GGong02/CAN-do-it_Capstone/perfboard_layout_bottom.png

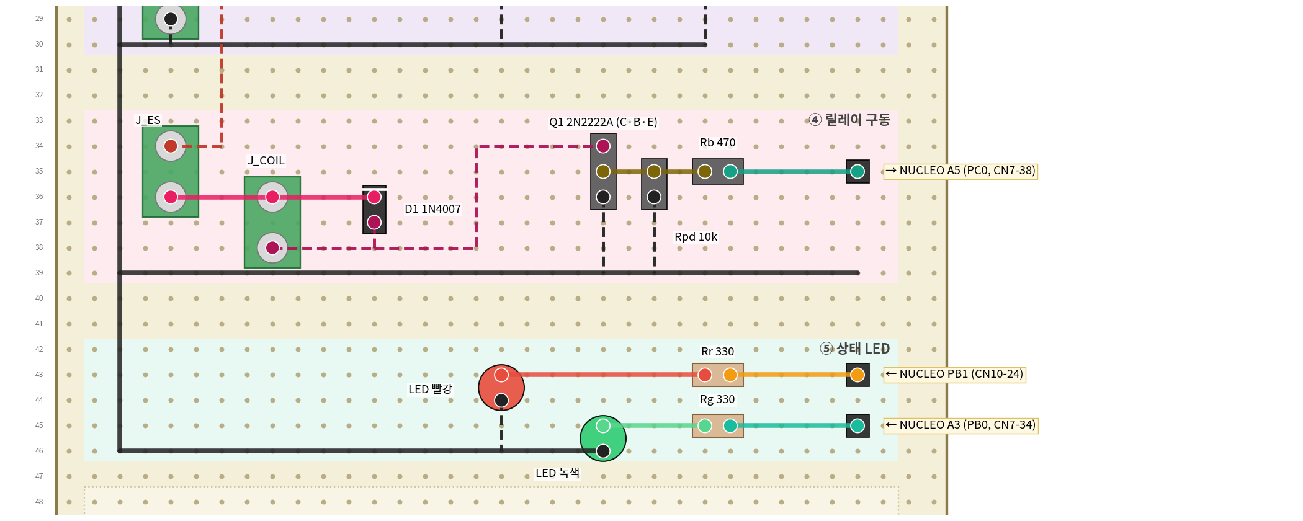
perfboard_layout_bottom.png
