GGong02/CAN-do-it_Capstone/perfboard_layout_full.png

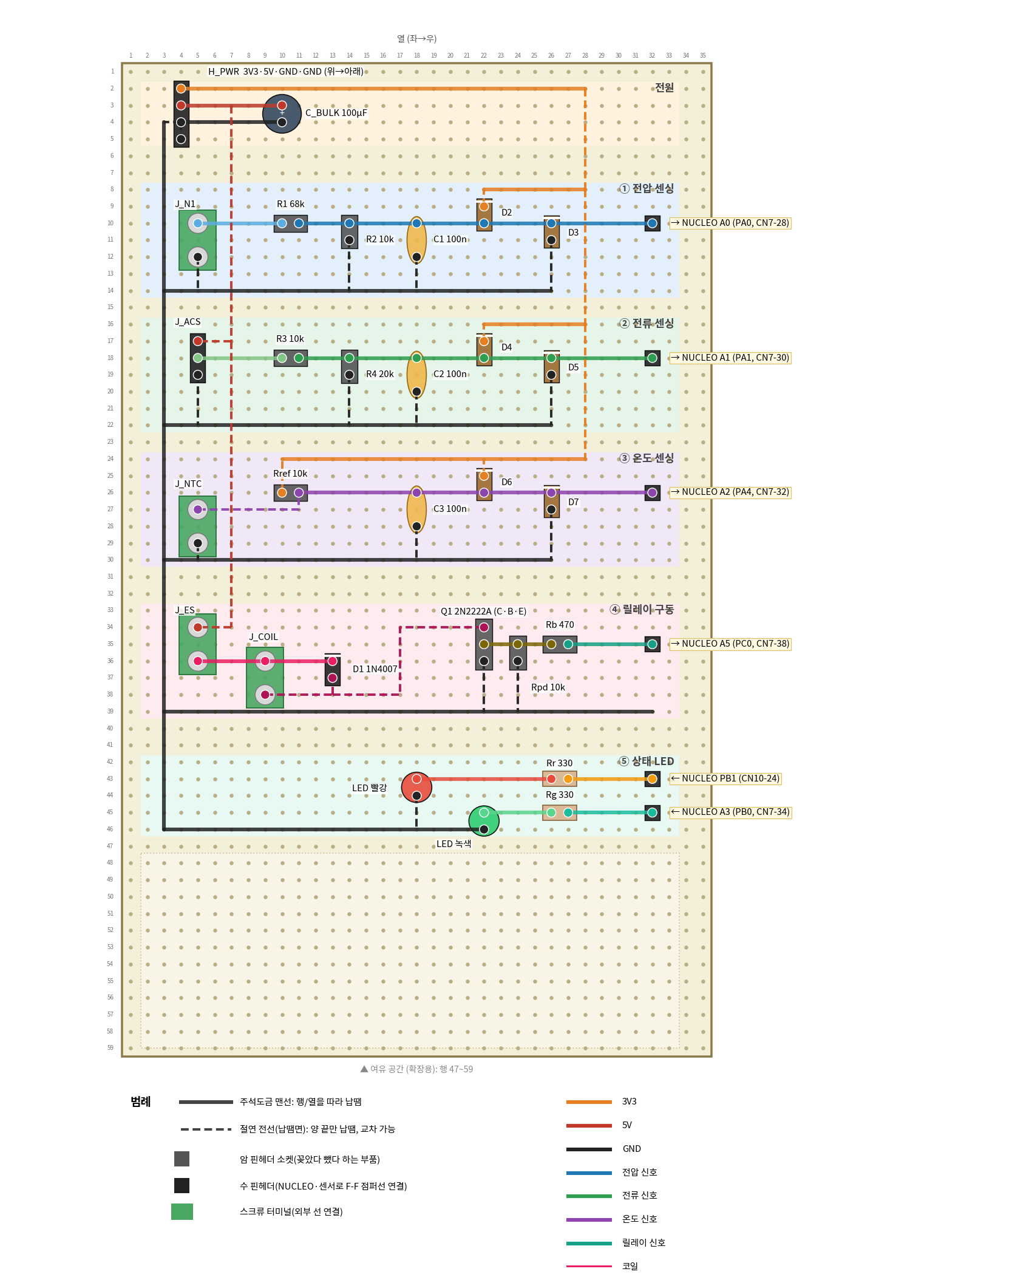
perfboard_layout_full.png
