GGong02/CAN-do-it_Capstone/perfboard_layout_top.png

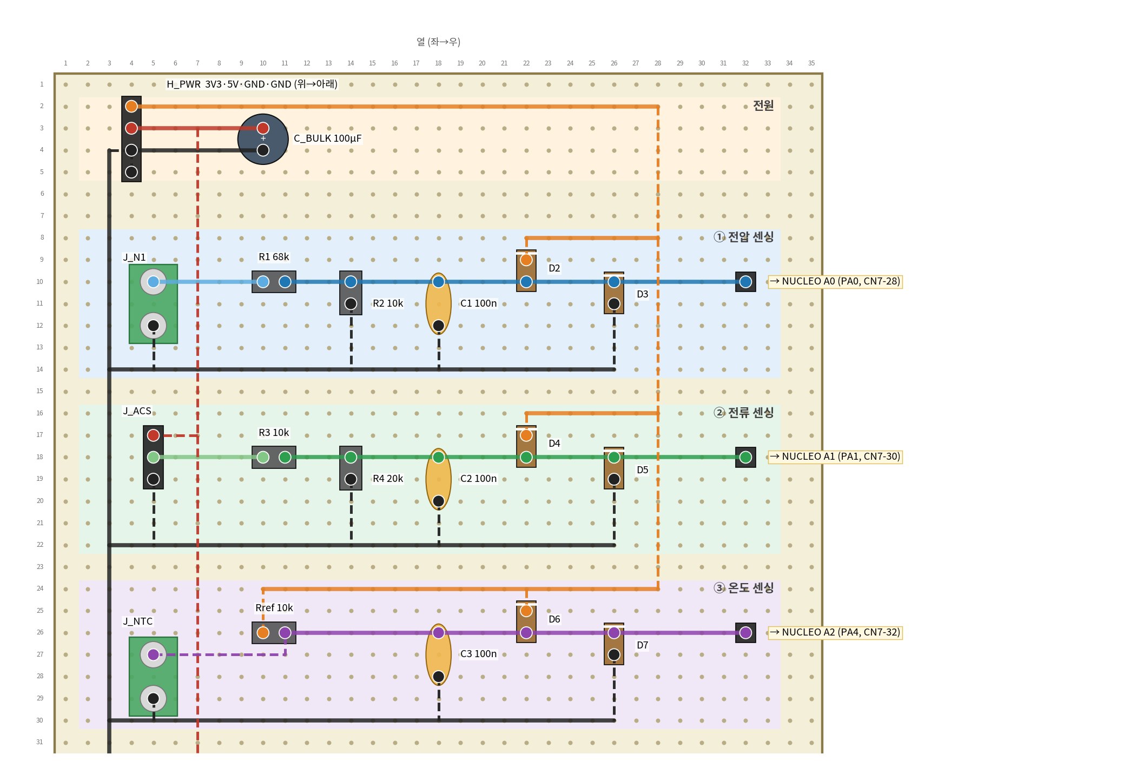
perfboard_layout_top.png
