GGong02/CAN-do-it_Capstone/parts_list_v3.xlsx

Sheet: 필수 부품
필수 부품 (34개 항목, v3: 만능기판 + 소켓 방식)
노란 칸(구매 상태)을 갱신하세요. 이미 구매한 점퍼선(M-M, M-F, F-F)과 라즈베리 파이는 '이미 보유' 시트로 옮겼습니다. 예) 구매 상태: 주문
번호 | 분류 | 부품명 | 규격 / 모델 예시 | 권장 수량 | 용도 | 구매 상태 | 비고
R-01 | 전력·보호 | 퓨즈 | 5×20mm 유리관 속단형 4A (F4A) | 5개 | 과전류 최후 보호 | 미구매 | 정상 약 1A, 시험 최대 약 2.5A. 파워서플라이 CC는 약 2.7A로 설정
R-02 | 전력·보호 | 퓨즈 홀더 | 5×20mm 인라인 또는 패널형 | 2개 | 퓨즈 장착 | 미구매
R-03 | 전력·보호 | 릴레이 | SRD-05VDC-SL-C (코일 5V, 접점 약 10A, DC 약 28~30V) | 2개 | 이상 시 부하 차단 | 미구매 | 기판 밖에 설치. 코일 핀에는 22AWG, 접점(COM, NO)에는 18AWG를 직접 납땜하고 열수축 처리. NO 접점 사용
R-04 | 전력·보호 | 전류 센서 모듈 | ACS712-05B (±5A, 185mV/A) | 2개 | 부하 전류 측정 | 미구매 | 기판의 J_ACS 수 핀 3개에 F-F 점퍼로 연결. 핀 순서(VCC, OUT, GND)는 모듈 표기로 확인
R-05 | 전력·보호 | NTC 서미스터 | 10kΩ, B=3950, 프로브형(케이블 약 1m) | 2개 | 과온도 감지 | 미구매 | 시험 부하(12Ω 저항) 표면에 부착
R-06 | 전력·보호 | 비상 정지 스위치 | 푸시버튼 또는 버섯형, NC(상시 닫힘) | 1개 | 릴레이 코일 5V 라인을 끊어 MCU와 무관하게 차단 | 미구매 | 기판의 J_ES 터미널 2개에 직렬로 연결
R-07 | 전력·보호 | 스크류 터미널 (기판용) | 5.08mm 피치 2핀, PCB 납땜형 | 6개 | J_N1, J_NTC, J_ES, J_COIL 4개 + 예비 2개 | 미구매 | 만능기판 구멍 2칸 간격에 맞는 5.08mm 제품
R-08 | 전력·보호 | 터미널 블록 (대전류 경로용) | 나사식 2P~4P, 10A 이상, 패널 또는 DIN형 | 4개 | 퓨즈, 전류 센서, 릴레이 접점, 부하의 대전류 선 연결 | 미구매 | 기판 밖에서 사용. 만능기판에 올리지 않음
R-09 | 전력·보호 | 전선 | 18AWG 실리콘 전선 (적/흑) | 각 2m | 주 전력 경로 | 미구매
R-10 | 구동·표시 | NPN 트랜지스터 | 2N2222A (또는 BC337) | 3개 | 릴레이 코일 구동 | 미구매 | TO-92는 핀 순서가 E-B-C(PN2222A)와 C-B-E(BC337)로 다름. 소켓은 위→아래 C, B, E
R-11 | 구동·표시 | 다이오드 | 1N4007 | 3개 | 릴레이 코일 플라이백 | 미구매 | 띠(캐소드)를 코일 + 쪽으로
R-12 | 구동·표시 | LED 5mm | 녹색, 빨간색 | 각 3개 | 정상/차단 표시 | 미구매
R-13 | 센싱 회로 | 저항 10kΩ 1% 1/4W | 금속피막 | 10개 | R2, R3, Rref, Rpd 4개 + 예비 | 미구매 | 소켓에 꽂을 저항 다리는 너무 굵지 않은 것(0.6mm 이하)
R-14 | 센싱 회로 | 저항 68kΩ 1% 1/4W | 금속피막 | 3개 | 전압 분압 R1 | 미구매 | 12V → ADC 약 1.54V, 측정 가능 최대 약 25.7V
R-15 | 센싱 회로 | 저항 20kΩ 1% 1/4W | 금속피막 | 3개 | 전류 센서 출력 분압 R4 | 미구매
R-16 | 센싱 회로 | 저항 470Ω 1/4W | 탄소 또는 금속피막 | 3개 | 트랜지스터 베이스 저항 Rb | 미구매
R-17 | 센싱 회로 | 저항 330Ω 1/4W | 탄소 또는 금속피막 | 4개 | LED 전류 제한 2개 + 예비 | 미구매
R-18 | 센싱 회로 | 세라믹 커패시터 100nF | 50V | 10개 | C1~C3 (ADC 필터) + 예비 | 미구매
R-19 | 센싱 회로 | 전해 커패시터 100µF | 25V | 3개 | 5V 라인 안정화 (C_BULK 1개 + 예비) | 미구매 | 긴 다리가 +
R-20 | 센싱 회로 | 소신호 쇼트키 다이오드 | BAT85 (저누설) | 8개 | ADC 입력 클램프 D2~D7 6개 + 예비 2개 | 미구매 | 띠(캐소드) 방향 주의
R-21 | 기판 제작 | 만능기판 | 9×15cm, 양면 스루홀 도트형(구멍 2.54mm) | 2개 | 신호 회로 기판 + 예비 1개 | 미구매 | 줄무늬(스트립) 기판이 아니라 구멍이 독립된 도트형
R-22 | 기판 제작 | 암 핀헤더 (소켓용) | 1×40, 2.54mm 피치 | 2개 | 저항 7개(2핀)와 Q1(3핀)용 소켓 = 17핀 + 예비 | 미구매 | 필요한 길이로 잘라서 사용
R-23 | 기판 제작 | 수 핀헤더 | 1×40, 2.54mm 피치 | 2개 | 전원 4핀, J_ACS 3핀, 신호 6핀 = 13핀 + 예비 | 미구매 | F-F 점퍼선이 꽂히는 핀
R-24 | 기판 제작 | 배선용 절연 전선 | 22~26AWG 단선, 여러 색 | 1세트 | 납땜면 점대점 배선 | 미구매 | 피복 벗기기 쉬운 단선
R-25 | 기판 제작 | 주석도금 동선 (맨선) | 0.6~0.8mm 단선 | 1m | 행/열 따라 가는 버스 배선 | 미구매 | 남는 저항 다리로 대체 가능
R-26 | 기판 제작 | 납땜 도구 세트 | 온도조절 인두, 납(0.8mm), 플럭스, 솔더윅, 니퍼, 와이어 스트리퍼 | 1세트 | 납땜, 수정 | 미구매 | 이미 있으면 제외
R-27 | 제작·시험 | 브레드보드 | 830핀 | 1개 | 납땜 전 회로 시험 | 미구매 | 수정이 잦을 것이므로 먼저 시험 권장
R-28 | 제작·시험 | 열수축 튜브 세트 |  | 1세트 | 릴레이 핀과 전선 연결부 절연 | 미구매
R-29 | 시험 부하 | 알루미늄 방열 저항 50W 12Ω | 알루미늄 하우징형 | 1개 | 상시 부하 (12V에서 약 1A, 약 12W) | 미구매 | NTC를 이 저항에 부착
R-30 | 시험 부하 | 알루미늄 방열 저항 50W 8.2Ω | 알루미늄 하우징형 | 1개 | 과전류 시험용 추가 부하 (병렬 투입 시 약 2.5A) | 미구매 | 12V에서 이 저항만 약 18W 발열: 짧게만 시험
R-31 | 시험 부하 | 토글 스위치 | SPST, 10A 이상 | 1개 | 8.2Ω 부하를 병렬로 투입/분리 | 미구매 | 과전류 시험 스위치
R-32 | 시험 부하 | 방열판 + 고정 나사 | 저항을 장착할 수 있는 알루미늄 방열판 | 2개 | 저항 방열 | 미구매 | 방열판 없이는 매우 뜨거워짐
R-33 | 시험 부하 | 카프톤 테이프 또는 써멀 테이프 |  | 1세트 | NTC를 저항에 고정 | 미구매
R-34 | 제작·시험 | 디지털 멀티미터 |  | 1개 | 전압, 저항, 도통 측정 | 미구매 | 이미 있으면 제외. 납땜 후 단락·도통 확인에 필수

Sheet: 추가·선택 부품
추가로 필요할 수 있는 부품 (17개 항목, v3)
상황에 따라 필요한 부품입니다. 필요해지는 시점에 구매 상태를 갱신하세요.
번호 | 분류 | 부품명 | 규격 / 모델 예시 | 권장 수량 | 필요한 경우 / 용도 | 구매 상태 | 비고
O-01 | 표시 | 능동 부저 5V | 트랜지스터(2N2222A + 1kΩ)로 구동 | 2개 | 경보음 | 미구매 | PC1에 연결 예정. 기판 여유 공간(행 47~59)에 추가 가능
O-02 | 보호 | TVS 다이오드 | SMBJ15A 또는 P6KE18A | 2개 | 입력 전압 서지 보호 | 미구매 | 전원 공급기에서 스파이크가 의심될 때
O-03 | 보호 | 역극성 보호 | 쇼트키 다이오드(SB560 등) 또는 P-MOSFET 모듈 | 1개 | 전원 극성 반대 연결 방지 | 미구매 | 전류가 크면 다이오드 발열 주의
O-04 | 측정 | INA226 또는 INA219 모듈 | I2C 전압·전류 측정 | 1개 | 정밀 측정 대안 | 미구매 | ACS712 노이즈나 정확도가 부족할 때. 측정 전압 범위 확인
O-05 | 차단 | DC용 SSR | DC-DC 40A급 모듈 | 1개 | 릴레이 대체(아크, 수명) | 미구매 | 릴레이 접점이 부하에 맞지 않을 때
O-06 | 차단 | 릴레이 모듈 5V (트랜지스터 구동형) | 1채널, 접점 스크류 터미널 | 1개 | 릴레이 배선이 어려울 때 대체 | 미구매 | IN 논리(Active LOW/HIGH)에 따라 기판의 구동부(Q1, Rb, D1)를 생략. 부팅 시 동작 확인 필요
O-07 | 전류 | ACS712-20A 모듈 | ±20A, 100mV/A | 1개 | 부하 전류를 키울 때 | 미구매 | 현재 계획(2A 차단)에는 불필요
O-08 | 제작 | 케이스와 스탠드오프 |  | 1세트 | 보드 고정, 감전 방지 | 미구매 | 기판 모서리 구멍에 맞는 M3 스탠드오프
O-09 | 제작 | 기판 홀더 (제3의 손) |  | 1개 | 납땜 작업 보조 | 미구매
O-10 | 제작 | 이소프로필 알코올과 칫솔 |  | 1세트 | 플럭스 세척 | 미구매
O-11 | 제작 | 보안경 |  | 1개 | 납땜 튐 방지 | 미구매
O-12 | 시험 | 악어클립/바나나 케이블 |  | 각 2개 | 파워서플라이 연결 | 미구매
O-13 | 시험 | 로직 애널라이저 8채널 | 24MHz급 | 1개 | CAN, SPI 신호 디버깅 | 미구매 | 오실로스코프를 쓸 수 있으면 제외
O-14 | 시험 | 히트건 또는 드라이어 |  | 1개 | 과온도 시험(NTC 가열) | 미구매 | 사실상 시험에 필요: 구하기 어렵다면 필수로 전환
O-15 | 통신 | SN65HVD230 모듈 (예비) | SEENGREAT [220493] | 1개 | 손상 대비 예비 | 미구매
O-16 | 통신 | 저항 120Ω | 1/4W | 4개 | CAN 종단 예비 | 미구매 | 현재는 모듈, HAT 점퍼로 종단 중
O-17 | 시험 | USB 아이솔레이터 |  | 1개 | PC와의 접지 루프, 노이즈 차단 | 미구매 | 측정값이 불안정하거나 접지 문제가 있을 때

Sheet: 이미 보유
이미 구매한 부품
구매한 부품 목록입니다. 확인할 점을 점검하세요.
번호 | 부품 | 용도 | 상태 | 확인할 점
O-1 | 라즈베리 파이 4 Model B 8GB (가이드북, 방열판 포함) | 마스터(대시보드, CAN 수신) | 보유 | 전원 어댑터(5V/3A 이상)가 별도로 있는지 확인
O-2 | 2채널 CAN HAT (모델명 미확인) | 라즈베리 파이 CAN 통신 | 보유 | 모델명과 VIO 점퍼(3V3) 위치 확인
O-3 | NUCLEO-F103RB | 센서 노드 (STM32) | 보유
O-4 | SN65HVD230 CAN 모듈 (SEENGREAT [220493]) | STM32 CAN 트랜시버 | 보유 | CAN 통신 연결 완료
O-5 | 점퍼선 세트 (M-M, M-F, F-F) | 기판과 NUCLEO, ACS712 연결 | 보유 | 기판의 수 핀과 NUCLEO 핀을 F-F로 연결: 약 12가닥(전원 3 + 신호 6 + ACS712 3) 필요. 길이와 수량 확인
O-6 | 임베디드 보드(NUCLEO)용 전원 어댑터 | NUCLEO 전원 | 보유 | 출력 전압/전류와 연결 방식(USB, 외부 전원 핀) 확인. 5V 핀에서 릴레이 코일 약 70mA + ACS712 약 10mA를 공급해야 함

Sheet: 기판 부품 배치
기판 부품 배치표 (9×15cm 만능기판, 세로 방향)
열은 왼쪽에서 오른쪽(1~35), 행은 위에서 아래(1~59)로 센 구멍 번호입니다. 배치도 이미지의 눈금과 같습니다. 핀 위치 열·행 구멍에 해당 부품(또는 소켓 핀)의 다리를 납땜하세요.
번호 | 기호 | 설치 방식 | 설명 | 값 | 핀 위치 | 네트 | 비고
1 | H_PWR | 수 핀헤더 납땜 | 전원 입력 핀 (수 핀헤더 1x4) | 3V3 / 5V / GND / GND | 3V3: 열4·행2 / 5V: 열4·행3 / GND1: 열4·행4 / GND2: 열4·행5 | 3V3=3V3 / 5V=5V / GND1=GND / GND2=GND
2 | C_BULK | 직접 납땜 | 전해 커패시터 (5V 안정화) | 100µF 25V | +: 열10·행3 / −: 열10·행4 | +=5V / −=GND | 긴 다리가 +
3 | J_N1 | 스크류 터미널 납땜 | 스크류 터미널 2핀 (퓨즈 출력 N1 / 전원 −) | 5.08mm | N1: 열5·행10 / GND: 열5·행12 | N1=N1 / GND=GND
4 | R1 | 소켓에 꽂기 (암 핀헤더 납땜) | 분압 저항 (소켓) | 68kΩ 1% | a: 열10·행10 / b: 열11·행10 | a=N1 / b=ADC_V
5 | R2 | 소켓에 꽂기 (암 핀헤더 납땜) | 분압 저항 (소켓) | 10kΩ 1% | a: 열14·행10 / b: 열14·행11 | a=ADC_V / b=GND
6 | C1 | 직접 납땜 | 세라믹 커패시터 | 100nF | a: 열18·행10 / b: 열18·행12 | a=ADC_V / b=GND
7 | D2 | 직접 납땜 | 쇼트키 클램프 (BAT85) 상단 | BAT85 | A: 열22·행10 / K: 열22·행9 | A=ADC_V / K=3V3 | 띠(캐소드)가 위쪽(3V3 쪽)
8 | D3 | 직접 납땜 | 쇼트키 클램프 (BAT85) 하단 | BAT85 | K: 열26·행10 / A: 열26·행11 | K=ADC_V / A=GND | 띠(캐소드)가 위쪽(ADC 쪽)
9 | PA0 | 수 핀헤더 납땜 | 출력 핀 → NUCLEO PA0 | 수 핀 1개 | PA0: 열32·행10 | PA0=ADC_V
10 | J_ACS | 수 핀헤더 납땜 | ACS712 연결 핀 (수 핀헤더 1x3) | VCC / OUT / GND | VCC: 열5·행17 / OUT: 열5·행18 / GND: 열5·행19 | VCC=5V / OUT=ACS_OUT / GND=GND | 모듈 핀 순서를 확인하고 필요하면 바꿔 연결
11 | R3 | 소켓에 꽂기 (암 핀헤더 납땜) | 전류 분압 저항 (소켓) | 10kΩ 1% | a: 열10·행18 / b: 열11·행18 | a=ACS_OUT / b=ADC_I
12 | R4 | 소켓에 꽂기 (암 핀헤더 납땜) | 전류 분압 저항 (소켓) | 20kΩ 1% | a: 열14·행18 / b: 열14·행19 | a=ADC_I / b=GND
13 | C2 | 직접 납땜 | 세라믹 커패시터 | 100nF | a: 열18·행18 / b: 열18·행20 | a=ADC_I / b=GND
14 | D4 | 직접 납땜 | 쇼트키 클램프 (BAT85) 상단 | BAT85 | A: 열22·행18 / K: 열22·행17 | A=ADC_I / K=3V3 | 띠가 위쪽
15 | D5 | 직접 납땜 | 쇼트키 클램프 (BAT85) 하단 | BAT85 | K: 열26·행18 / A: 열26·행19 | K=ADC_I / A=GND | 띠가 위쪽
16 | PA1 | 수 핀헤더 납땜 | 출력 핀 → NUCLEO PA1 | 수 핀 1개 | PA1: 열32·행18 | PA1=ADC_I
17 | RREF | 소켓에 꽂기 (암 핀헤더 납땜) | NTC 기준 저항 (소켓) | 10kΩ 1% | a: 열10·행26 / b: 열11·행26 | a=3V3 / b=ADC_T
18 | J_NTC | 스크류 터미널 납땜 | 스크류 터미널 2핀 (NTC 프로브) | 5.08mm | NTC+: 열5·행27 / NTC−: 열5·행29 | NTC+=ADC_T / NTC−=GND | 극성 없음
19 | C3 | 직접 납땜 | 세라믹 커패시터 | 100nF | a: 열18·행26 / b: 열18·행28 | a=ADC_T / b=GND
20 | D6 | 직접 납땜 | 쇼트키 클램프 (BAT85) 상단 | BAT85 | A: 열22·행26 / K: 열22·행25 | A=ADC_T / K=3V3 | 띠가 위쪽
21 | D7 | 직접 납땜 | 쇼트키 클램프 (BAT85) 하단 | BAT85 | K: 열26·행26 / A: 열26·행27 | K=ADC_T / A=GND | 띠가 위쪽
22 | PA4 | 수 핀헤더 납땜 | 출력 핀 → NUCLEO PA4 | 수 핀 1개 | PA4: 열32·행26 | PA4=ADC_T
23 | J_ES | 스크류 터미널 납땜 | 스크류 터미널 2핀 (비상 정지 스위치) | 5.08mm | 5V쪽: 열5·행34 / 코일쪽: 열5·행36 | 5V쪽=5V / 코일쪽=COIL_P | NC 스위치를 이 두 단자에 직렬로
24 | J_COIL | 스크류 터미널 납땜 | 스크류 터미널 2핀 (릴레이 코일) | 5.08mm | 코일+: 열9·행36 / 코일−: 열9·행38 | 코일+=COIL_P / 코일−=COIL_N | 릴레이 코일 핀 2개
25 | D1 | 직접 납땜 | 플라이백 다이오드 | 1N4007 | K: 열13·행36 / A: 열13·행37 | K=COIL_P / A=COIL_N | 띠(캐소드)가 위쪽, 코일 + 쪽
26 | Q1 | 소켓에 꽂기 (암 핀헤더 납땜) | NPN 트랜지스터 (소켓 1x3) | 2N2222A | C: 열22·행34 / B: 열22·행35 / E: 열22·행36 | C=COIL_N / B=BASE / E=GND | 소켓 위→아래 = C, B, E. PN2222A(E-B-C)는 180° 돌려 꽂기
27 | RB | 소켓에 꽂기 (암 핀헤더 납땜) | 베이스 저항 (소켓) | 470Ω | a: 열26·행35 / b: 열27·행35 | a=BASE / b=RELAY
28 | RPD | 소켓에 꽂기 (암 핀헤더 납땜) | 풀다운 저항 (소켓) | 10kΩ | a: 열24·행35 / b: 열24·행36 | a=BASE / b=GND
29 | PC0 | 수 핀헤더 납땜 | 출력 핀 ← NUCLEO PC0 | 수 핀 1개 | PC0: 열32·행35 | PC0=RELAY
30 | RLED_R | 직접 납땜 | LED 저항 | 330Ω | a: 열26·행43 / b: 열27·행43 | a=LEDR_A / b=PB1
31 | LED_R | 직접 납땜 | 빨간 LED | 5mm | A: 열18·행43 / K: 열18·행44 | A=LEDR_A / K=GND | 긴 다리가 A(위)
32 | PB1 | 수 핀헤더 납땜 | 입력 핀 ← NUCLEO PB1 | 수 핀 1개 | PB1: 열32·행43 | PB1=PB1
33 | RLED_G | 직접 납땜 | LED 저항 | 330Ω | a: 열26·행45 / b: 열27·행45 | a=LEDG_A / b=PB0
34 | LED_G | 직접 납땜 | 녹색 LED | 5mm | A: 열22·행45 / K: 열22·행46 | A=LEDG_A / K=GND | 긴 다리가 A(위)
35 | PB0 | 수 핀헤더 납땜 | 입력 핀 ← NUCLEO PB0 | 수 핀 1개 | PB0: 열32·행45 | PB0=PB0

Sheet: 기판 배선표
기판 배선표 (납땜면)
맨선은 해당 행/열을 따라 놓고 지나는 핀 구멍마다 납땜합니다. 절연 전선은 양 끝 구멍만 납땜하고, 중간에서 다른 선과 교차해도 됩니다. 맨선 구간에는 다른 전선이 닿지 않게 하세요.
번호 | 네트 | 종류 | 시작 | 끝 | 경유(꺾이는 점) | 설명
1 | 3V3 | 맨선(주석도금 단선) | 열4·행2 (H_PWR.3V3) | 열28·행2 |  | 3V3 상단 줄
2 | 3V3 | 절연 전선 | 열28·행2 | 열28·행8 |  | 3V3 세로 버스
3 | 3V3 | 절연 전선 | 열28·행8 | 열28·행16 |  | 3V3 세로 버스
4 | 3V3 | 절연 전선 | 열28·행16 | 열28·행24 |  | 3V3 세로 버스
5 | 3V3 | 맨선(주석도금 단선) | 열22·행8 | 열28·행8 |  | 전압 센싱 3V3 줄
6 | 3V3 | 맨선(주석도금 단선) | 열22·행16 | 열28·행16 |  | 전류 센싱 3V3 줄
7 | 3V3 | 맨선(주석도금 단선) | 열10·행24 | 열28·행24 |  | 온도 센싱 3V3 줄
8 | 3V3 | 절연 전선 | 열22·행9 (D2.K) | 열22·행8 |  | D2 캐소드 → 3V3 줄
9 | 3V3 | 절연 전선 | 열22·행17 (D4.K) | 열22·행16 |  | D4 캐소드 → 3V3 줄
10 | 3V3 | 절연 전선 | 열22·행25 (D6.K) | 열22·행24 |  | D6 캐소드 → 3V3 줄
11 | 3V3 | 절연 전선 | 열10·행26 (RREF.a) | 열10·행24 |  | RREF 위쪽 다리 → 3V3 줄
12 | 5V | 맨선(주석도금 단선) | 열4·행3 (H_PWR.5V) | 열10·행3 (C_BULK.+) |  | 5V 상단 줄 (C_BULK 연결)
13 | 5V | 절연 전선 | 열7·행3 | 열7·행17 |  | 5V 세로 버스
14 | 5V | 절연 전선 | 열7·행17 | 열5·행17 (J_ACS.VCC) |  | ACS712 VCC
15 | 5V | 절연 전선 | 열7·행17 | 열7·행34 |  | 5V 세로 버스
16 | 5V | 절연 전선 | 열7·행34 | 열5·행34 (J_ES.5V쪽) |  | 비상 정지 5V 쪽
17 | GND | 맨선(주석도금 단선) | 열4·행4 (H_PWR.GND1) | 열10·행4 (C_BULK.−) |  | GND 상단 줄 (C_BULK −)
18 | GND | 절연 전선 | 열4·행4 (H_PWR.GND1) | 열3·행4 |  | GND 버스 시작
19 | GND | 절연 전선 | 열4·행4 (H_PWR.GND1) | 열4·행5 (H_PWR.GND2) |  | GND 핀 2개 연결
20 | GND | 맨선(주석도금 단선) | 열3·행4 | 열3·행46 |  | GND 세로 버스 (왼쪽 가장자리)
21 | GND | 맨선(주석도금 단선) | 열3·행14 | 열26·행14 |  | GND 가로 줄 (행 14)
22 | GND | 맨선(주석도금 단선) | 열3·행22 | 열26·행22 |  | GND 가로 줄 (행 22)
23 | GND | 맨선(주석도금 단선) | 열3·행30 | 열26·행30 |  | GND 가로 줄 (행 30)
24 | GND | 맨선(주석도금 단선) | 열3·행39 | 열32·행39 |  | GND 가로 줄 (행 39)
25 | GND | 맨선(주석도금 단선) | 열3·행46 | 열22·행46 (LED_G.K) |  | GND 가로 줄 (행 46)
26 | GND | 절연 전선 | 열14·행11 (R2.b) | 열14·행14 |  | R2 → GND 줄
27 | GND | 절연 전선 | 열18·행12 (C1.b) | 열18·행14 |  | C1 → GND 줄
28 | GND | 절연 전선 | 열26·행11 (D3.A) | 열26·행14 |  | D3 → GND 줄
29 | GND | 절연 전선 | 열5·행12 (J_N1.GND) | 열5·행14 |  | J_N1 → GND 줄
30 | GND | 절연 전선 | 열14·행19 (R4.b) | 열14·행22 |  | R4 → GND 줄
31 | GND | 절연 전선 | 열18·행20 (C2.b) | 열18·행22 |  | C2 → GND 줄
32 | GND | 절연 전선 | 열26·행19 (D5.A) | 열26·행22 |  | D5 → GND 줄
33 | GND | 절연 전선 | 열5·행19 (J_ACS.GND) | 열5·행22 |  | J_ACS → GND 줄
34 | GND | 절연 전선 | 열18·행28 (C3.b) | 열18·행30 |  | C3 → GND 줄
35 | GND | 절연 전선 | 열26·행27 (D7.A) | 열26·행30 |  | D7 → GND 줄
36 | GND | 절연 전선 | 열5·행29 (J_NTC.NTC−) | 열5·행30 |  | J_NTC → GND 줄
37 | GND | 절연 전선 | 열22·행36 (Q1.E) | 열22·행39 |  | Q1 에미터 → GND 줄
38 | GND | 절연 전선 | 열24·행36 (RPD.b) | 열24·행39 |  | RPD → GND 줄
39 | GND | 절연 전선 | 열18·행44 (LED_R.K) | 열18·행46 |  | LED_R → GND 줄
40 | N1 | 맨선(주석도금 단선) | 열5·행10 (J_N1.N1) | 열10·행10 (R1.a) |  | J_N1 → R1
41 | ADC_V | 맨선(주석도금 단선) | 열11·행10 (R1.b) | 열32·행10 (PA0.PA0) |  | 전압 센싱 신호 줄
42 | ACS_OUT | 맨선(주석도금 단선) | 열5·행18 (J_ACS.OUT) | 열10·행18 (R3.a) |  | ACS712 OUT → R3
43 | ADC_I | 맨선(주석도금 단선) | 열11·행18 (R3.b) | 열32·행18 (PA1.PA1) |  | 전류 센싱 신호 줄
44 | ADC_T | 맨선(주석도금 단선) | 열11·행26 (RREF.b) | 열32·행26 (PA4.PA4) |  | 온도 센싱 신호 줄
45 | ADC_T | 절연 전선 | 열5·행27 (J_NTC.NTC+) | 열11·행26 (RREF.b) | 열11·행27 | J_NTC → 신호 줄
46 | COIL_P | 맨선(주석도금 단선) | 열5·행36 (J_ES.코일쪽) | 열13·행36 (D1.K) |  | 비상 정지 → 코일+ / D1 캐소드
47 | COIL_N | 절연 전선 | 열9·행38 (J_COIL.코일−) | 열13·행38 |  | 코일− → D1 쪽
48 | COIL_N | 절연 전선 | 열13·행38 | 열13·행37 (D1.A) |  | D1 애노드
49 | COIL_N | 절연 전선 | 열13·행38 | 열22·행34 (Q1.C) | 열17·행38 → 열17·행34 | 코일− → Q1 컬렉터
50 | BASE | 맨선(주석도금 단선) | 열22·행35 (Q1.B) | 열26·행35 (RB.a) |  | Q1 베이스 줄 (RPD 포함)
51 | RELAY | 맨선(주석도금 단선) | 열27·행35 (RB.b) | 열32·행35 (PC0.PC0) |  | PC0 신호 줄
52 | PB1 | 맨선(주석도금 단선) | 열27·행43 (RLED_R.b) | 열32·행43 (PB1.PB1) |  | PB1 신호 줄
53 | LEDR_A | 맨선(주석도금 단선) | 열26·행43 (RLED_R.a) | 열18·행43 (LED_R.A) |  | 빨간 LED 애노드 줄
54 | PB0 | 맨선(주석도금 단선) | 열27·행45 (RLED_G.b) | 열32·행45 (PB0.PB0) |  | PB0 신호 줄
55 | LEDG_A | 맨선(주석도금 단선) | 열26·행45 (RLED_G.a) | 열22·행45 (LED_G.A) |  | 녹색 LED 애노드 줄

Sheet: 외부 연결표
외부 연결표 (기판 ↔ NUCLEO / 센서 / 전원)
기판의 수 핀헤더와 NUCLEO, ACS712 모듈은 F-F 점퍼선으로 연결합니다. 스크류 터미널에는 전선을 물려 연결합니다. 부하 전류가 흐르는 선은 기판에 연결하지 않습니다.
기판 단자 | 기판 위치 | 연결 대상 | 연결 대상 위치 | 방법
H_PWR 3V3 | 열4·행2 | NUCLEO 3V3 | CN7-16 | F-F 점퍼
H_PWR 5V | 열4·행3 | NUCLEO 5V | CN7-18 | F-F 점퍼
H_PWR GND | 열4·행4 (예비: 열4·행5) | NUCLEO GND | CN7-19, 20, 22 중 하나 | F-F 점퍼
PA0 (전압) | 열32·행10 | NUCLEO PA0 (A0) | CN7-28 | F-F 점퍼
PA1 (전류) | 열32·행18 | NUCLEO PA1 (A1) | CN7-30 | F-F 점퍼
PA4 (온도) | 열32·행26 | NUCLEO PA4 (A2) | CN7-32 | F-F 점퍼
PC0 (릴레이) | 열32·행35 | NUCLEO PC0 (A5) | CN7-38 | F-F 점퍼
PB1 (빨간 LED) | 열32·행43 | NUCLEO PB1 | CN10-24 | F-F 점퍼
PB0 (녹색 LED) | 열32·행45 | NUCLEO PB0 (A3) | CN7-34 | F-F 점퍼
J_ACS VCC / OUT / GND | 열5·행17 / 18 / 19 | ACS712 모듈 VCC / OUT / GND | 모듈 헤더 | F-F 점퍼 3가닥 (핀 순서 확인)
J_N1 (N1) | 열5·행10 | 퓨즈 출력(릴레이 앞) |  | 가는 전선 (24AWG 이상), 최대 24V 주의
J_N1 (GND) | 열5·행12 | 파워서플라이 − |  | 가는 전선
J_NTC | 열5·행27 / 29 | NTC 프로브 2선 |  | 나사 체결 (극성 없음)
J_ES | 열5·행34 / 36 | 비상 정지 스위치 (NC) 2선 |  | 나사 체결, 5V 라인에 직렬
J_COIL | 열9·행36 / 38 | 릴레이 코일 핀 2개 |  | 22AWG 전선, 나사 체결 (코일 극성 없음, D1 방향만 맞출 것)
기판 밖 대전류 경로 (터미널 블록으로 배선)
파워서플라이 + → 퓨즈 → ACS712 IP+/IP− → 릴레이 COM → NO → 부하(12Ω, 스위치로 8.2Ω 병렬) → 파워서플라이 −. 퓨즈 출력에서 가는 선 하나를 J_N1(N1)로 분기.

Sheet: 기준값·ADC 코드
차단 기준값과 ADC 코드 계산
파란 글씨 = 입력값, 검은 글씨 = 계산식, 노란 칸 = 팀에서 확정할 기준값. 기준값을 바꾸면 ADC 코드가 자동으로 바뀝니다.
입력값
정상 동작 전압 | 12 | V | 시험 기준 전압
분압 저항 R1 | 68 | kΩ | v2 이후 선택값
분압 저항 R2 | 10 | kΩ
ADC 기준전압 | 3.3 | V | NUCLEO 3V3
ADC 분해능 | 12 | bit | STM32F103
과전압 차단 | 14 | V | 정상의 약 117%
과전압 복귀 | 13 | V | 이 값 미만으로 내려가야 복귀 허용
전류 센서 감도 | 0.185 | V/A | ACS712-05B
전류 센서 0A 출력 | 2.5 | V | 시작 시 실측 보정
전류 출력 분압 R3 | 10 | kΩ
전류 출력 분압 R4 | 20 | kΩ | GND 쪽
과전류 차단 | 2.0 | A | 정상(약 1A)의 2배. 복귀는 수동 리셋
상시 부하 저항 | 12 | Ω | 50W 알루미늄 저항
추가 시험 부하 저항 | 8.2 | Ω | 스위치로 병렬 투입
NTC 25°C 저항 | 10 | kΩ
NTC B값 | 3950 | K
NTC 기준저항 Rref | 10 | kΩ | 3.3V 쪽
과온도 차단 | 60 | °C
과온도 복귀 | 50 | °C | 이 값 미만으로 내려가야 복귀 허용
계산 결과: 전압
분압비 | 0.1282 |  | R2 / (R1 + R2)
정상 전압 시 ADC 입력 | 1.538 | V
측정 가능 최대 전압 | 25.7 | V | 이 값 이상은 ADC 포화. 공급기 전압을 이보다 높이지 말 것
과전압 차단 ADC 코드 | 2227 | code | 이 코드 이상이면 차단
과전압 복귀 ADC 코드 | 2068 | code | 이 코드 미만이면 복귀 가능
계산 결과: 전류
출력 분압비 | 0.6667 |  | R4 / (R3 + R4)
0A일 때 ADC 코드 | 2068 | code | 영점 보정 기준
상시 부하 전류 | 1.00 | A
시험 부하 전류 (병렬 투입) | 2.46 | A | 공급기 CC는 이보다 약간 높게(약 2.7A)
과전류 차단 ADC 코드 | 2374 | code | 이 코드 이상이면 차단
시험 부하 시 ADC 코드 | 2445 | code
시험 전류가 차단 기준을 넘는가 | OK: 차단 시험 가능
정격 5A에서 ADC 범위 | OK |  | ACS712-05B 풀스케일 기준
계산 결과: 온도
과온도에서 NTC 저항 | 2.486 | kΩ | Beta 식
과온도 차단 ADC 코드 | 815 | code | 온도가 오르면 코드가 내려가므로 이 코드 이하이면 차단
복귀 온도에서 NTC 저항 | 3.588 | kΩ
과온도 복귀 ADC 코드 | 1081 | code | 이 코드 초과이면 복귀 가능
계산 결과: 부하 전력
상시 부하 전력 | 12.0 | W | 방열판 필수
추가 부하 전력 | 17.6 | W | 짧게만 시험
과전압 차단 직전 상시 부하 전력 | 16.3 | W
