GGong02/CAN-do-it_Capstone/battery_front.asc

C1: cap; 100n
D1: diode; D1N4007
Lcoil: ind; 100m
Q1: npn; Q2N2222
R1: res; 30k
R2: res; 10k
Rb: res; 1k
Rcoil: res; 70
Rntc: res; R={10k*exp(3950*(1/(Tc+273.15)-1/298.15))}
Rref: res; 10k
V3v3: voltage; 3.3
V5: voltage; 5
Vbat: voltage; 12.6
Vpc0: voltage; PULSE(0 3.3 10m 1u 1u 40m 100m)
Named nets: 0, adc0, adc4, coll
1) Voltage divider (3S Li-ion, 12.6V)
2) NTC divider (10k, B=3950)
.param Tc=25
3) Relay driver (PC0 -> 2N2222 -> coil, flyback diode)
.model D1N4007 D(IS=76.9p RS=42m N=1.45 BV=1000 IBV=5u CJO=26.5p M=0.333 TT=4.32u)
.model Q2N2222 NPN(IS=14.34f BF=255.9 VAF=74.03 IKF=0.2847 NE=1.307 ISE=14.34f BR=6.092 RB=10 RC=1 CJE=22.01p CJC=7.306p TF=411.1p TR=46.91n)
.tran 150m
