GGong02/CAN-do-it_Capstone/(commit log)

2026-09-18 First commit: 테스트 파일 업로드
2026-10-29 회로도 및 관련 부품 리스트 업데이트
    [parts_list_v3.xlsx]
